better-baby-buggies/hardware/common_lib/Nano_33/images/arduino-nano-every.jpeg

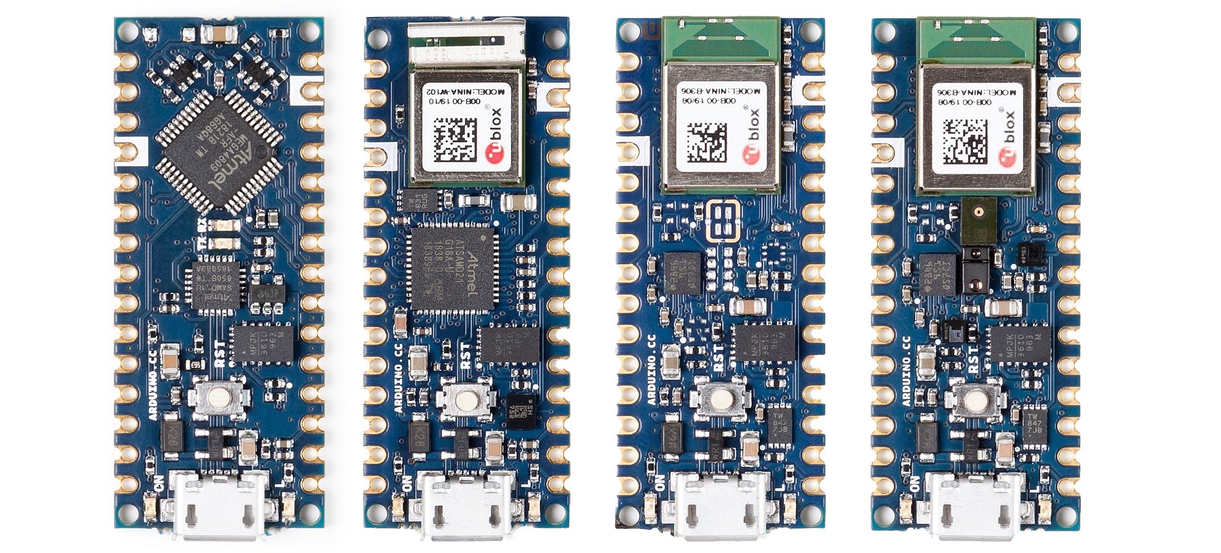
common_lib/Nano_33/images/arduino-nano-every.jpeg
