better-baby-buggies/hardware/README.md

# hardware
Hardware designs for the PCB's in our Better Baby Buggy!
