better-baby-buggies/hardware/common_lib/Nano_33/images/002.png

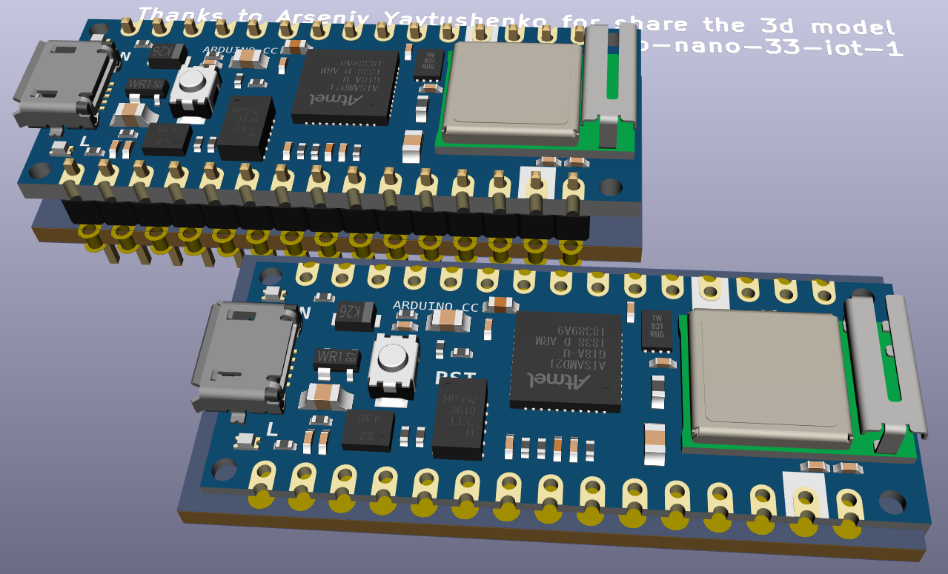
common_lib/Nano_33/images/002.png
