better-baby-buggies/hardware/common_lib/Nano_33/images/003.png

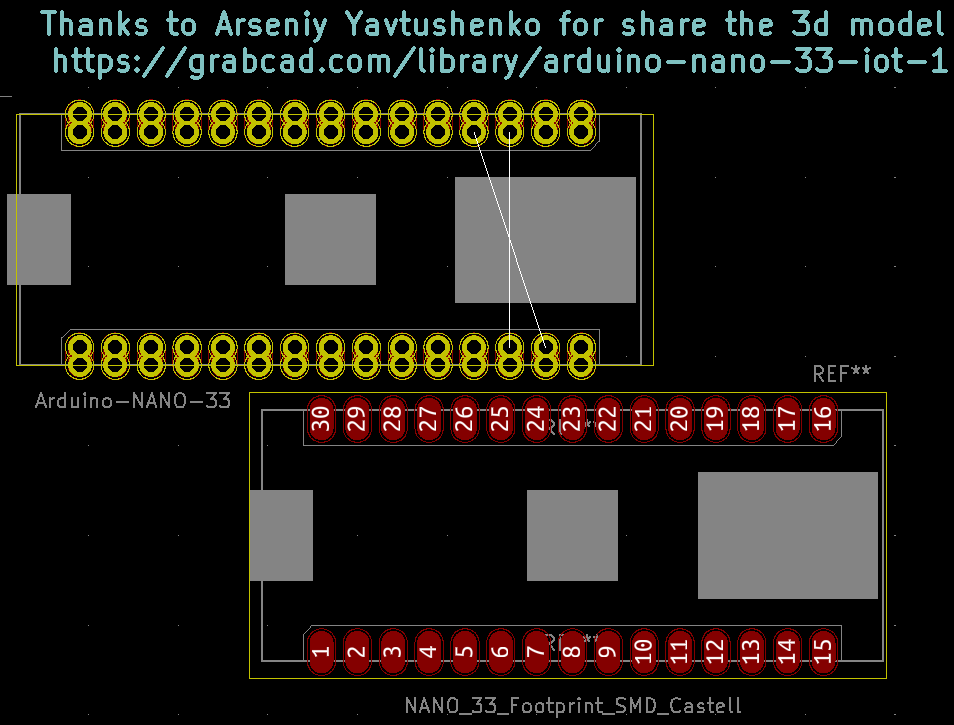
common_lib/Nano_33/images/003.png
