better-baby-buggies/hardware/key_fob/key_fob_rev1.pdf

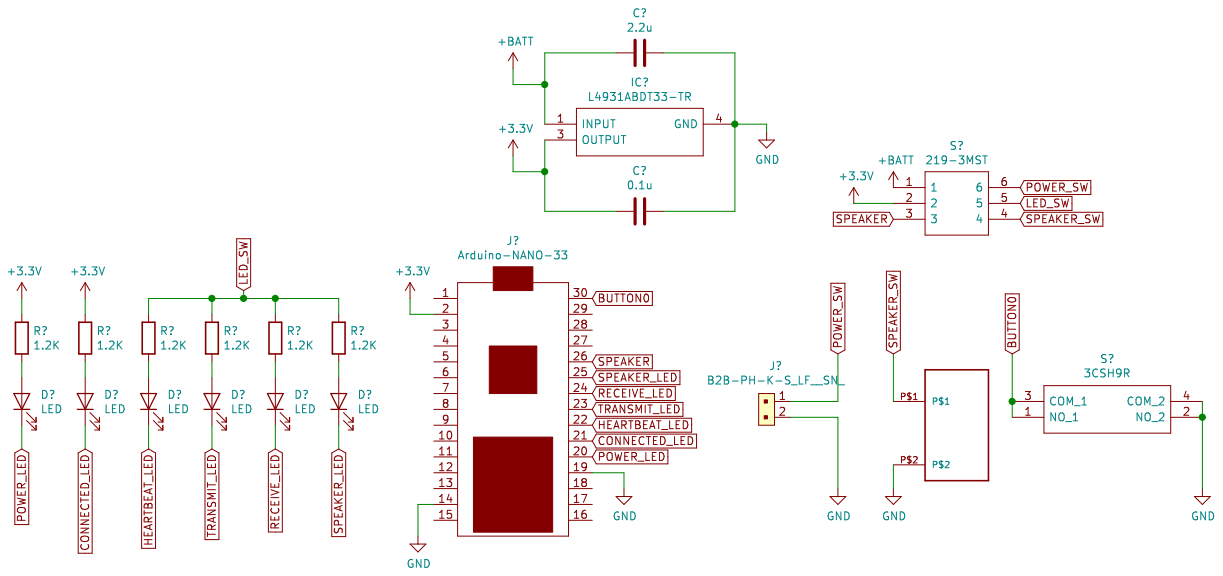
[picture p5: page 1]
