better-baby-buggies/hardware/key_fob/key_fob.pdf

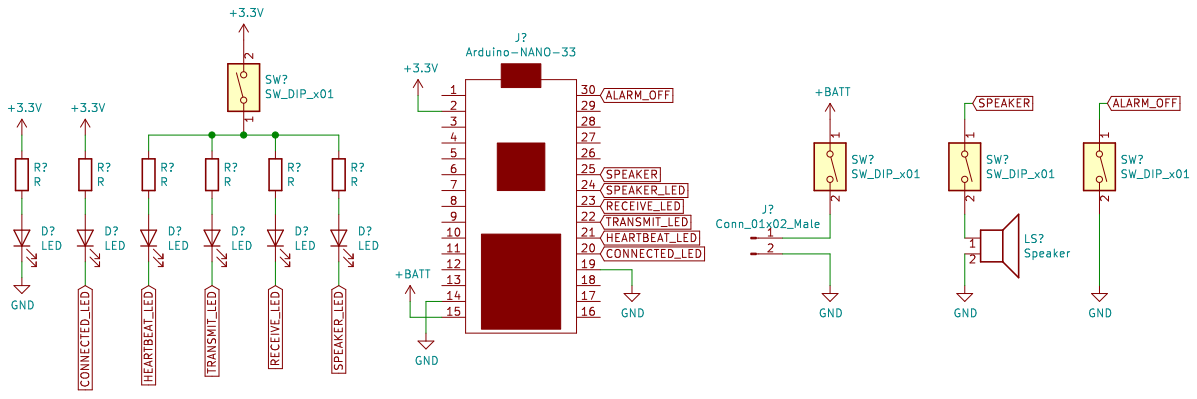
[picture p6: page 1]
