better-baby-buggies/hardware/key_fob/key_fob.kicad_pcb

## KiCad design key_fob/key_fob.kicad_pcb (2020-03-03)

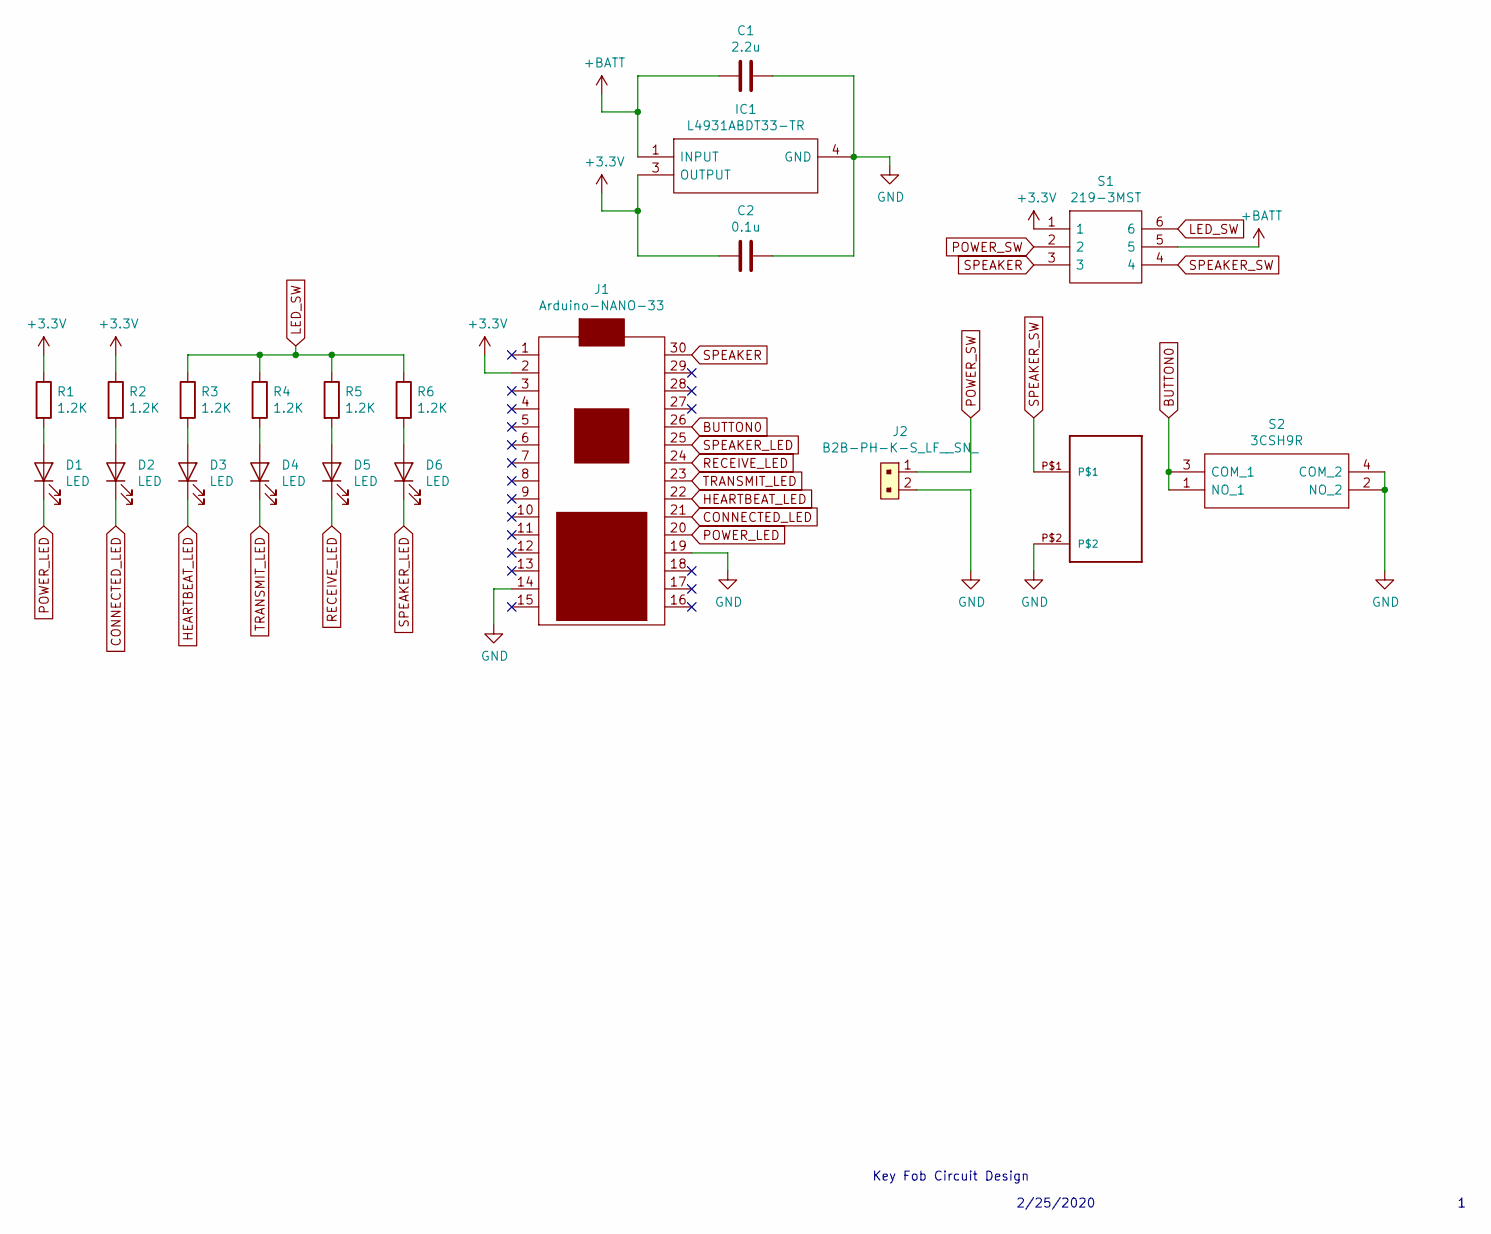
[picture p7: schematic key_fob.sch]

Parts:
C1: 2.2u; C_0603_1608Metric_Pad1.05x0.95mm_HandSolder
C2: 0.1u; C_0603_1608Metric_Pad1.05x0.95mm_HandSolder
D1, D2: LED; LED_D5.0mm
D3, D4, D5, D6: LED; LED_1206_3216Metric_Pad1.42x1.75mm_HandSolder
IC1: L4931ABDT33-TR; TO228P972X240-3N; Mouser Part Number 511-L4931ABDT33-TR
J1: Arduino-NANO-33; NANO_33_Footprint_SMD_Castell
J2: B2B-PH-K-S_LF__SN_; PinHeader_1x2_P2mm_Drill1mm; MPN B2B-PH-K-S(LF)(SN); Digi-Key_PN 455-1704-ND
R1, R2, R3, R4, R5, R6: 1.2K; R_0603_1608Metric_Pad1.05x0.95mm_HandSolder
S1: 219-3MST; SOP254P991X385-6N; Mouser Part Number 774-2193MST
S2: 3CSH9R; Mouser Part Number 642-3CSH9R
U1: PS1240P02BT

Connections:
+3V3: C2.1, IC1.3 (OUTPUT), J1.2, R1.1, R2.1, S1.1
+BATT: C1.2, IC1.1 (INPUT), S1.5
BUTTON0: J1.26, S2.1 (NO_1), S2.3 (COM_1)
CONNECTED_LED: D2.1 (K), J1.21
GND: C1.1, C2.2, IC1.4 (GND), J1.14, J1.19, J2.2, S2.2 (NO_2), S2.4 (COM_2), U1.P$2
HEARTBEAT_LED: D3.1 (K), J1.22
LED_SW: R3.1, R4.1, R5.1, R6.1, S1.6
unnamed: D1.2 (A), R1.2
unnamed: D2.2 (A), R2.2
unnamed: D3.2 (A), R3.2
unnamed: D4.2 (A), R4.2
unnamed: D5.2 (A), R5.2
unnamed: D6.2 (A), R6.2
POWER_LED: D1.1 (K), J1.20
POWER_SW: J2.1, S1.2
RECEIVE_LED: D5.1 (K), J1.24
SPEAKER: J1.30, S1.3
SPEAKER_LED: D6.1 (K), J1.25
SPEAKER_SW: S1.4, U1.P$1
TRANSMIT_LED: D4.1 (K), J1.23

Notes on the sheet:
Key Fob Circuit Design
2/25/2020

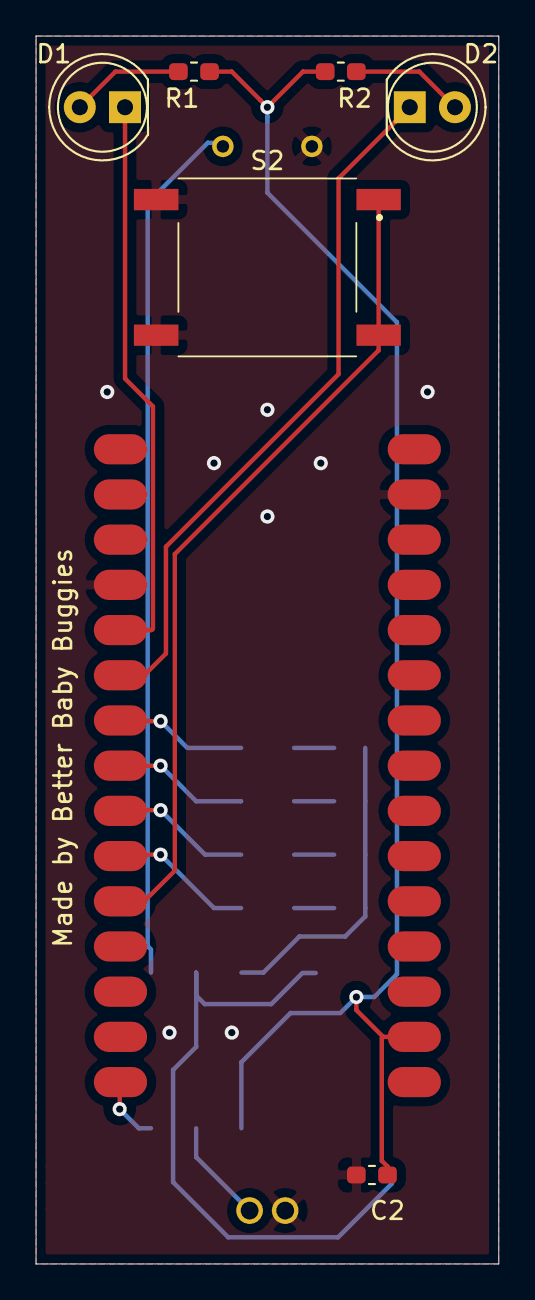
[picture p8: board key_fob.kicad_pcb from above]

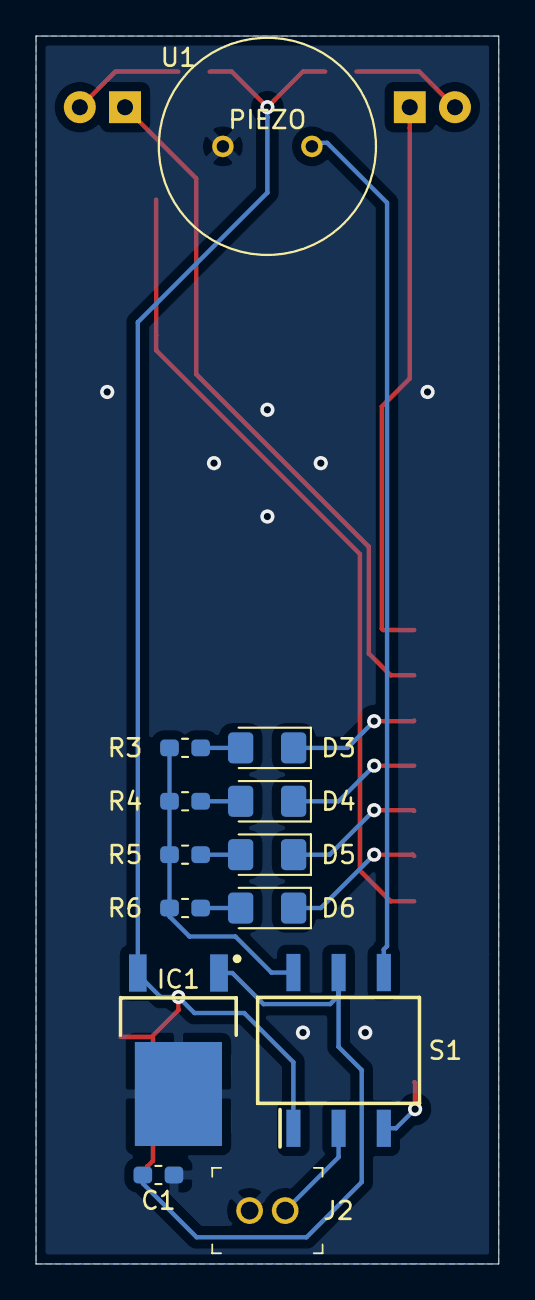
[picture p9: board key_fob.kicad_pcb from below]

Board: 2 copper layers, 26.0 x 69.0 mm, 20 parts (13 on the bottom side), 20 nets.
