better-baby-buggies/hardware/(commit log)

2020-01-28 Started project and added Nano_33 footprint library
    [Nano_33.kicad_pcb, Nano_33.sch, key_fob.kicad_pcb, key_fob.sch]
2020-01-28 Started Schmatic for key_fob
    [key_fob.sch]
2020-01-30 Updated schmatic to include alarm off button
    [key_fob.sch]
2020-02-14 Added footprint and symbol library for some of the parts picked out
    [familylist_refdes.csv, key_fob.sch]
2020-02-18 Added Mosfets for External LEDs
    [key_fob.sch]
2020-02-20 Linked all symbols to footprints
    [key_fob.sch]
2020-02-25 Changed external leds back to not using MOSFET
    [key_fob.sch]
2020-02-25 Filled out title block and printed rev1 pdf
    [key_fob.sch]
2020-02-25 Imported schematic into pcb layout
    [key_fob.kicad_pcb, key_fob.sch]
2020-03-03 Got some stuff started for key fod pcb
    [key_fob.kicad_pcb, key_fob.sch]
2020-03-03 First try at placing parts on PCB (no routing)
    [key_fob.kicad_pcb, key_fob.sch]
2020-03-03 Changed board size to 26x69mm
    [key_fob.kicad_pcb]
2020-03-03 Routed everything except the ground connections?=
    [key_fob.kicad_pcb]
2020-03-03 Cleaned up and mostly finished design
    [key_fob.kicad_pcb]
